urish/stm32-breakout-sao/README.md

# STM32 Breakout ShittyAddon

## PCB Renderings
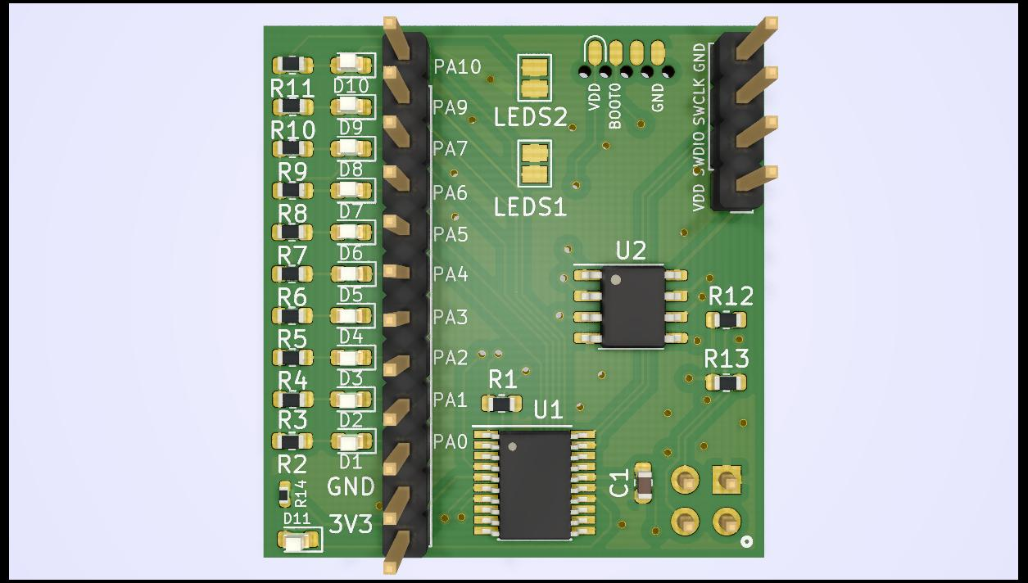
[picture p1: images/top.jpg]
Board top


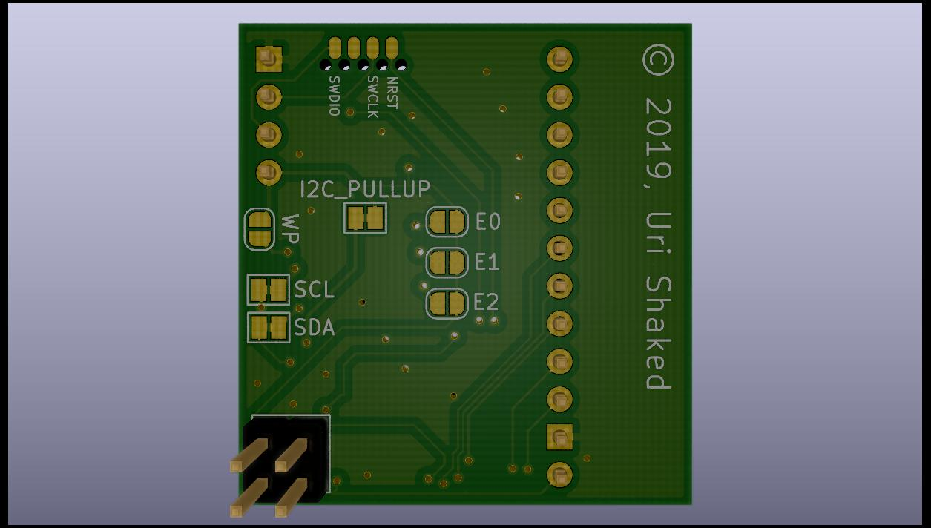
[picture p2: images/bottom.jpg]
Board bottom
