urish/stm32-breakout-sao/stm32-sao.kicad_pcb

## KiCad design stm32-sao.kicad_pcb (2020-01-15)

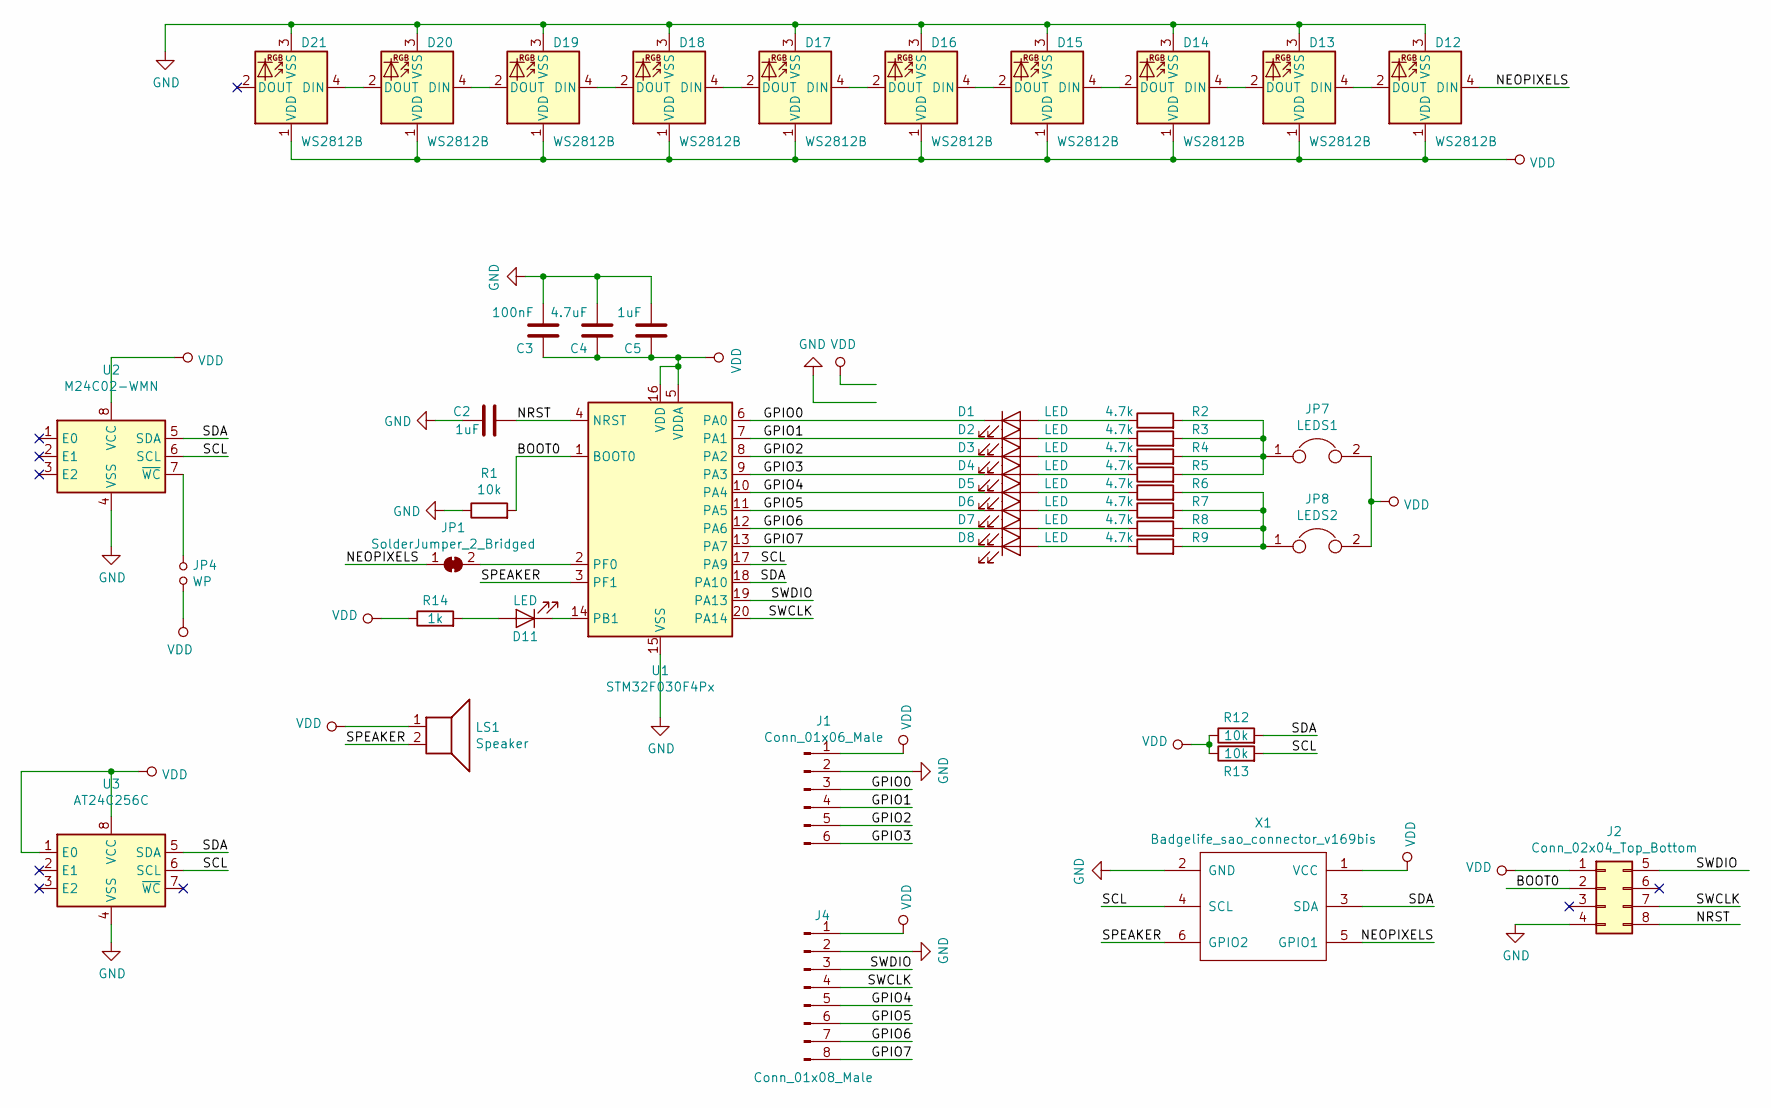
[picture p3: schematic stm32-sao.sch]

Parts:
C2, C5: 1uF; C_0402_1005Metric; LCSC Part C52923
C3: 100nF; C_0402_1005Metric; LCSC Part C1525
C4: 4.7uF; C_0402_1005Metric; LCSC Part C23733
D1: LED; LED_0603_1608Metric; LCSC Part C2286
D2, D3, D4, D5, D6, D7, D8: LED; LED_0603_1608Metric
D11: LED; LED_0603_1608Metric; LCSC Part C72041
D12: WS2812B; LED-SMD_4P-L3.5-W3.5-TL_WS2812B; LCSC Part C114583
D13, D14, D15, D16, D17, D18, D19, D20, D21: WS2812B; LED-SMD_4P-L3.5-W3.5-TL_WS2812B
J1: Conn_01x06_Male; PinHeader_1x06_P2.54mm_Vertical
J2: Conn_02x04_Top_Bottom; SOIC_clipProgSmall; JLCPCB BOM 0
J4: Conn_01x08_Male; PinHeader_1x08_P2.54mm_Vertical
JP1: SolderJumper_2_Bridged; SolderJumper-2_P1.3mm_Bridged_Pad1.0x1.5mm
JP4: WP; SolderJumper-2_P1.3mm_Open_RoundedPad1.0x1.5mm; JLCPCB BOM 0
JP7: LEDS1; SolderJumper-2_P1.3mm_Bridged_Pad1.0x1.5mm; JLCPCB BOM 0
JP8: LEDS2; SolderJumper-2_P1.3mm_Bridged_Pad1.0x1.5mm; JLCPCB BOM 0
LS1: Speaker; BUZZER-R14-2P-7.6PITCH
R1: 10k; R_0402_1005Metric; LCSC Part C25744
R2: 4.7k; R_0402_1005Metric; LCSC Part C25900
R3, R4, R5, R6, R7, R8, R9: 4.7k; R_0402_1005Metric
R12, R13: 10k; R_0402_1005Metric
R14: 1k; R_0402_1005Metric; LCSC Part C11702
U1: STM32F030F4Px; TSSOP-20_4.4x6.5mm_P0.65mm; LCSC Part C89040
U2: M24C02-WMN; SOIC-8_3.9x4.9mm_P1.27mm; LCSC Part C7562
U3: AT24C256C; SOIC-8_3.9x4.9mm_P1.27mm; LCSC Part C6482
X1: Badgelife_sao_connector_v169bis; Badgelife-SAOv169-SAO-2x3

Connections:
/BOOT0: J2.2, R1.2, U1.1 (BOOT0)
/GPIO0: D1.1 (K), J1.3, U1.6 (PA0)
/GPIO1: D2.1 (K), J1.4, U1.7 (PA1)
/GPIO2: D3.1 (K), J1.5, U1.8 (PA2)
/GPIO3: D4.1 (K), J1.6, U1.9 (PA3)
/GPIO4: D5.1 (K), J4.5, U1.10 (PA4)
/GPIO5: D6.1 (K), J4.6, U1.11 (PA5)
/GPIO6: D7.1 (K), J4.7, U1.12 (PA6)
/GPIO7: D8.1 (K), J4.8, U1.13 (PA7)
/NEOPIXELS: D12.4 (DIN), JP1.1 (A), X1.5 (GPIO1)
/NRST: C2.2, J2.8, U1.4 (NRST)
/SCL: R13.2, U1.17 (PA9), U2.6 (SCL), U3.6 (SCL), X1.4 (SCL)
/SDA: R12.2, U1.18 (PA10), U2.5 (SDA), U3.5 (SDA), X1.3 (SDA)
/SPEAKER: LS1.2, U1.3 (PF1), X1.6 (GPIO2)
/SWCLK: J2.7, J4.4, U1.20 (PA14)
/SWDIO: J2.5, J4.3, U1.19 (PA13)
GND: C2.1, C3.2, C4.2, C5.2, D12.3 (VSS), D13.3 (VSS), D14.3 (VSS), D15.3 (VSS), D16.3 (VSS), D17.3 (VSS), D18.3 (VSS), D19.3 (VSS), D20.3 (VSS), D21.3 (VSS), J1.2, J2.4, J4.2, R1.1, U1.15 (VSS), U2.4 (VSS), U3.4 (VSS), X1.2 (GND)
unnamed: D1.2 (A), R2.1
unnamed: D2.2 (A), R3.1
unnamed: D3.2 (A), R4.1
unnamed: D4.2 (A), R5.1
unnamed: D5.2 (A), R6.1
unnamed: D6.2 (A), R7.1
unnamed: D7.2 (A), R8.1
unnamed: D8.2 (A), R9.1
unnamed: D11.1 (K), U1.14 (PB1)
unnamed: D11.2 (A), R14.2
unnamed: D12.2 (DOUT), D13.4 (DIN)
unnamed: D13.2 (DOUT), D14.4 (DIN)
unnamed: D14.2 (DOUT), D15.4 (DIN)
unnamed: D15.2 (DOUT), D16.4 (DIN)
unnamed: D16.2 (DOUT), D17.4 (DIN)
unnamed: D17.2 (DOUT), D18.4 (DIN)
unnamed: D18.2 (DOUT), D19.4 (DIN)
unnamed: D19.2 (DOUT), D20.4 (DIN)
unnamed: D20.2 (DOUT), D21.4 (DIN)
unnamed: JP1.2 (B), U1.2 (PF0)
unnamed: JP4.1, U2.7 (~WC)
unnamed: JP7.1, R2.2, R3.2, R4.2, R5.2
unnamed: JP8.1, R6.2, R7.2, R8.2, R9.2
VDD: C3.1, C4.1, C5.1, D12.1 (VDD), D13.1 (VDD), D14.1 (VDD), D15.1 (VDD), D16.1 (VDD), D17.1 (VDD), D18.1 (VDD), D19.1 (VDD), D20.1 (VDD), D21.1 (VDD), J1.1, J2.1, J4.1, JP4.2, JP7.2, JP8.2, LS1.1, R12.1, R13.1, R14.1, U1.5 (VDDA), U1.16 (VDD), U2.8 (VCC), U3.1 (E0), U3.8 (VCC), X1.1 (VCC)

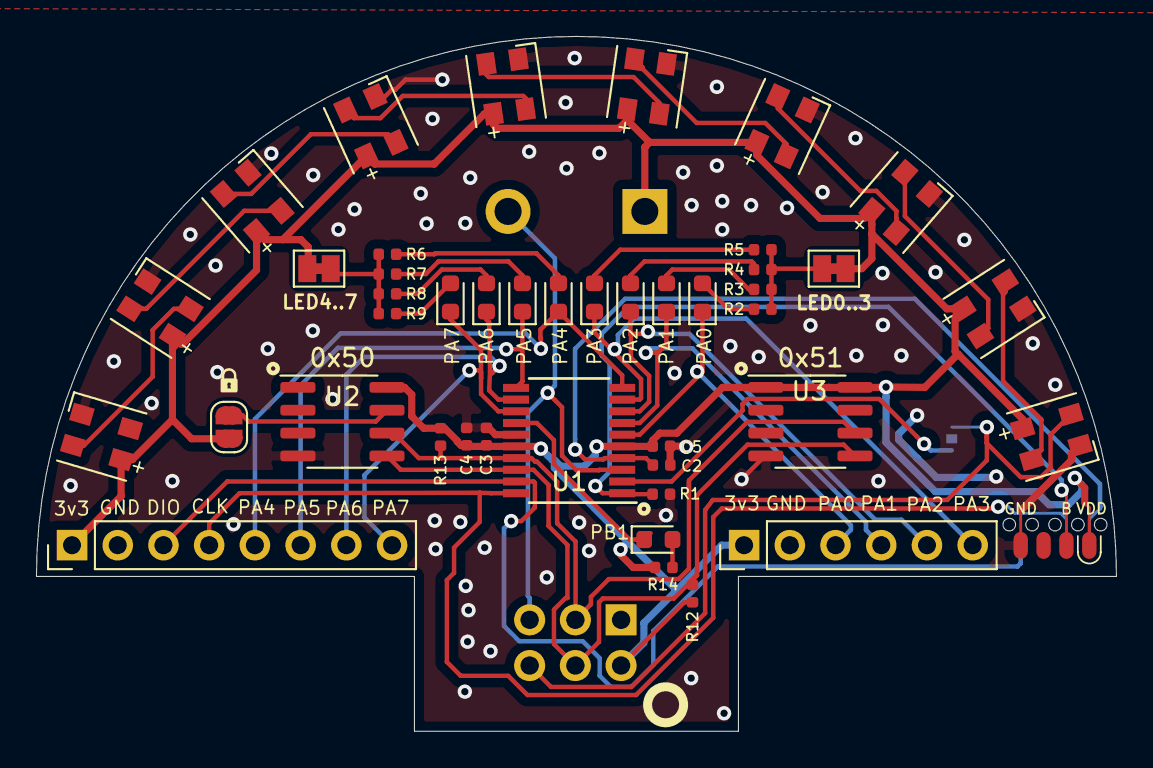
[picture p4: board stm32-sao.kicad_pcb from above]

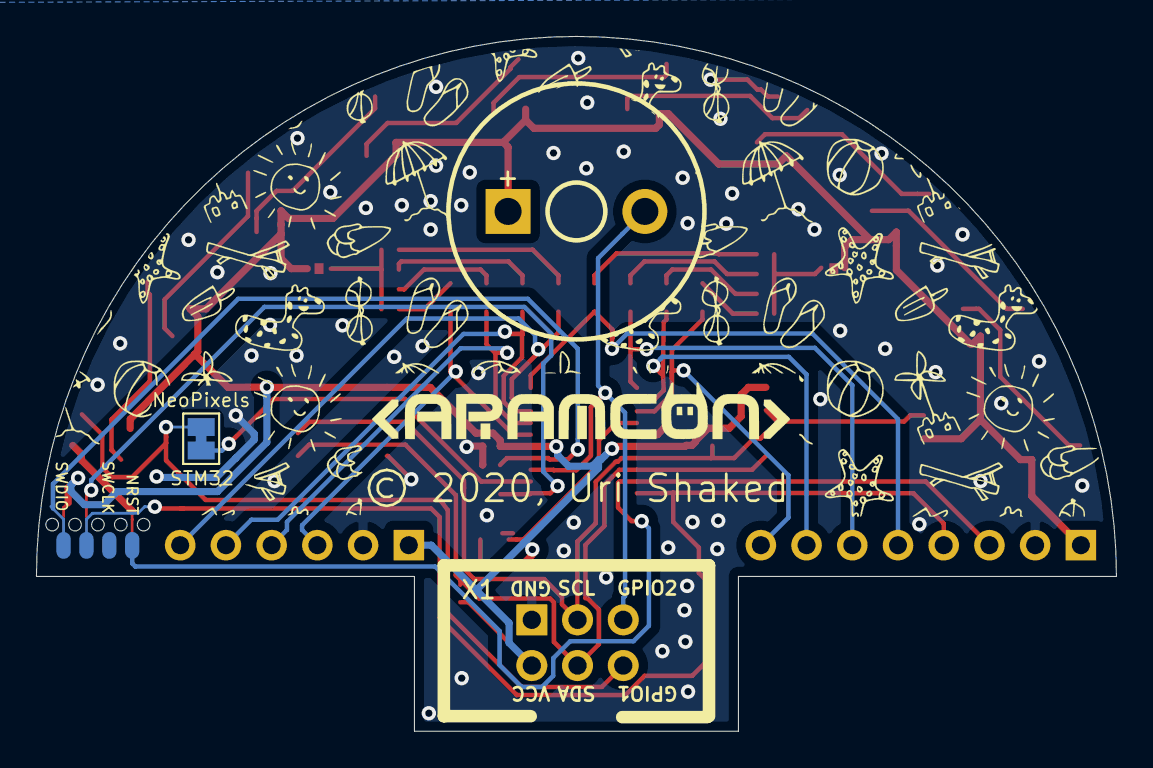
[picture p5: board stm32-sao.kicad_pcb from below]

Board: 2 copper layers, 60.0 x 38.6 mm, 50 parts (4 on the bottom side), 41 nets.

Other parts of the board:
Ref**: Val**; background
svg2mod: G***; aramcon-logo-2
svg2mod#2: G***; lock
