urish/stm32-breakout-sao/(commit log)

2019-09-27 fix: use male connector for SAO
    [stm32-sao.kicad_pcb, stm32-sao.sch]
2019-09-27 fix: optimize tracks + silk screen for pin 1
    reduce track width, remove unused tracks,
    mark UC pin 1 with a circle on silk screen
    [stm32-sao.kicad_pcb]
2019-10-13 fix: LEDs connected wrong
    they should be connected to VCC, not GND!
    [stm32-sao.kicad_pcb, stm32-sao.sch]
2019-10-15 fix: wrong I2C pins
    PA9/PA10 should be connected to the I2C bus instead of PF0/PF1
    [stm32-sao.kicad_pcb, stm32-sao.sch]
2019-10-19 fix: silk screen
    [stm32-sao.kicad_pcb]
2019-10-19 feat: sample firmware, control LEDs over UART
2019-10-26 feat: control LEDs in circle CircuitPython demo
2020-01-15 feat: second version of the PCB
    1. Upgrade #badgelife Shitty Add-On connector to V1.69bis
    2. Add 10 NeoPixels (WS2812B-Mini)
    3. Add a small 7mm speaker
    4. Redesign the board
    5. Add a second I2C EEPROM
    6. Add AramCon conference logo
    [stm32-sao.kicad_pcb, stm32-sao.sch]
2020-01-15 feat: add background pattern to back side
    [stm32-sao.kicad_pcb]
