urish/stm32-breakout-sao/(notices)

Notices in the files:
stm32-sao.kicad_pcb:
© 2020, Uri Shaked
